missioncreep11/rtk-wave-buoy/src/OpenLog_Artemis_GNSS_Logging_Modified/logging.cpp

#include "OpenLog_Artemis.h"
// logging.cpp
//Returns next available log file name
//Checks the spots in EEPROM for the next available LOG# file name
//Updates EEPROM and then appends to the new log file.
char* findNextAvailableLog(int &newFileNumber, const char *fileLeader)
{
  if (newFileNumber < 2) //If the settings have been reset, let's warn the user that this could take a while!
  {
    Serial.println(F("Finding the next available log file."));
    Serial.println(F("This could take a long time if the SD card contains many existing log files."));
  }

  if (newFileNumber > 0)
    newFileNumber--; //Check if last log file was empty

  //Search for next available log spot
  static char newFileName[40];
  while (1)
  {
    char newFileNumberStr[6];
    if (newFileNumber < 10)
      sprintf(newFileNumberStr, "0000%d", newFileNumber);
    else if (newFileNumber < 100)
      sprintf(newFileNumberStr, "000%d", newFileNumber);
    else if (newFileNumber < 1000)
      sprintf(newFileNumberStr, "00%d", newFileNumber);
    else if (newFileNumber < 10000)
      sprintf(newFileNumberStr, "0%d", newFileNumber);
    else
      sprintf(newFileNumberStr, "%d", newFileNumber);
    sprintf(newFileName, "%s%s.ubx", fileLeader, newFileNumberStr); //Splice the new file number into this file name. Max no. is 99999.

    if (settings.printMinorDebugMessages == true)
    {
      Serial.print(F("findNextAvailableLog: trying "));
      Serial.println(newFileName);
    }

    if (sd.exists(newFileName) == false) break; //File name not found so we will use it.

    //File exists — check if it is empty. If so, reuse it (matches IMU log behaviour).
    SdFile existingFile;
    existingFile.open(newFileName, O_READ);
    bool isEmpty = (existingFile.fileSize() == 0);
    existingFile.close();
    if (isEmpty) break;

    newFileNumber++; //Try the next number
  }

  newFileNumber++; //Increment so the next power up uses the next file #
  recordSettings(); //Record new file number to EEPROM and to config file (newFileNumber points to settings.nextDataLogNumber)

  Serial.print(F("Created log file: "));
  Serial.println(newFileName);

  return (newFileName);
}
//Returns next available IMU log file name - Amara
char* findNextAvailableIMULog(int fileNumber, const char *fileLeader)
{
  SdFile newFile; //This will contain the file for SD writing
  
  //Search for next available log spot
  static char newFileName[40];
  while (1)
  {
    char newFileNumberStr[6];
    if (fileNumber < 10)
      sprintf(newFileNumberStr, "0000%d", fileNumber);
    else if (fileNumber < 100)
      sprintf(newFileNumberStr, "000%d", fileNumber);
    else if (fileNumber < 1000)
      sprintf(newFileNumberStr, "00%d", fileNumber);
    else if (fileNumber < 10000)
      sprintf(newFileNumberStr, "0%d", fileNumber);
    else
      sprintf(newFileNumberStr, "%d", fileNumber);
    sprintf(newFileName, "%s%s.csv", fileLeader, newFileNumberStr); //Create CSV file for IMU

    if (sd.exists(newFileName) == false) break; //File name not found so we will use it.

    //File exists so open and see if it is empty. If so, use it.
    newFile.open(newFileName, O_READ);
    if (newFile.fileSize() == 0) break; // File is empty so we will use it.

    newFile.close(); // Close this existing file we just opened.

    fileNumber++; //Try the next number
  }
  
  newFile.close(); //Close this new file we just opened

  Serial.print(F("Created IMU log file: "));
  Serial.println(newFileName);

  return (newFileName);
}
