missioncreep11/rtk-wave-buoy/(commit log)

2026-05-29 Add battery-like modem recovery and Polaris exploration docs.
    PWRKEY power cycle runs before RST with boot-style UART reconfig, 20s off-time, and ESP restart on failure. Document Point One Polaris trials and LTE integration path for future developers.
    [buoy_combo.h]
2026-07-15 All print msgs now work over BLE and serial
2026-07-16 removed redundant gps print block and unused vars
2026-08-13 removed BLE RX defines by accident - fixed
    [buoy_combo.ino]
2026-08-18 minor cast/type fixes, fixed int overflow instance, reworked gprs attach logic, shutdown flag now resets
    [buoy_combo.h, buoy_combo.ino]
2026-09-03 switch sample rate to 4hz and moved project python requirements
